JonathSpirit/GP8B/Project_GP8B.kicad_pcb

## KiCad design Project_GP8B.kicad_pcb (2023-03-18)

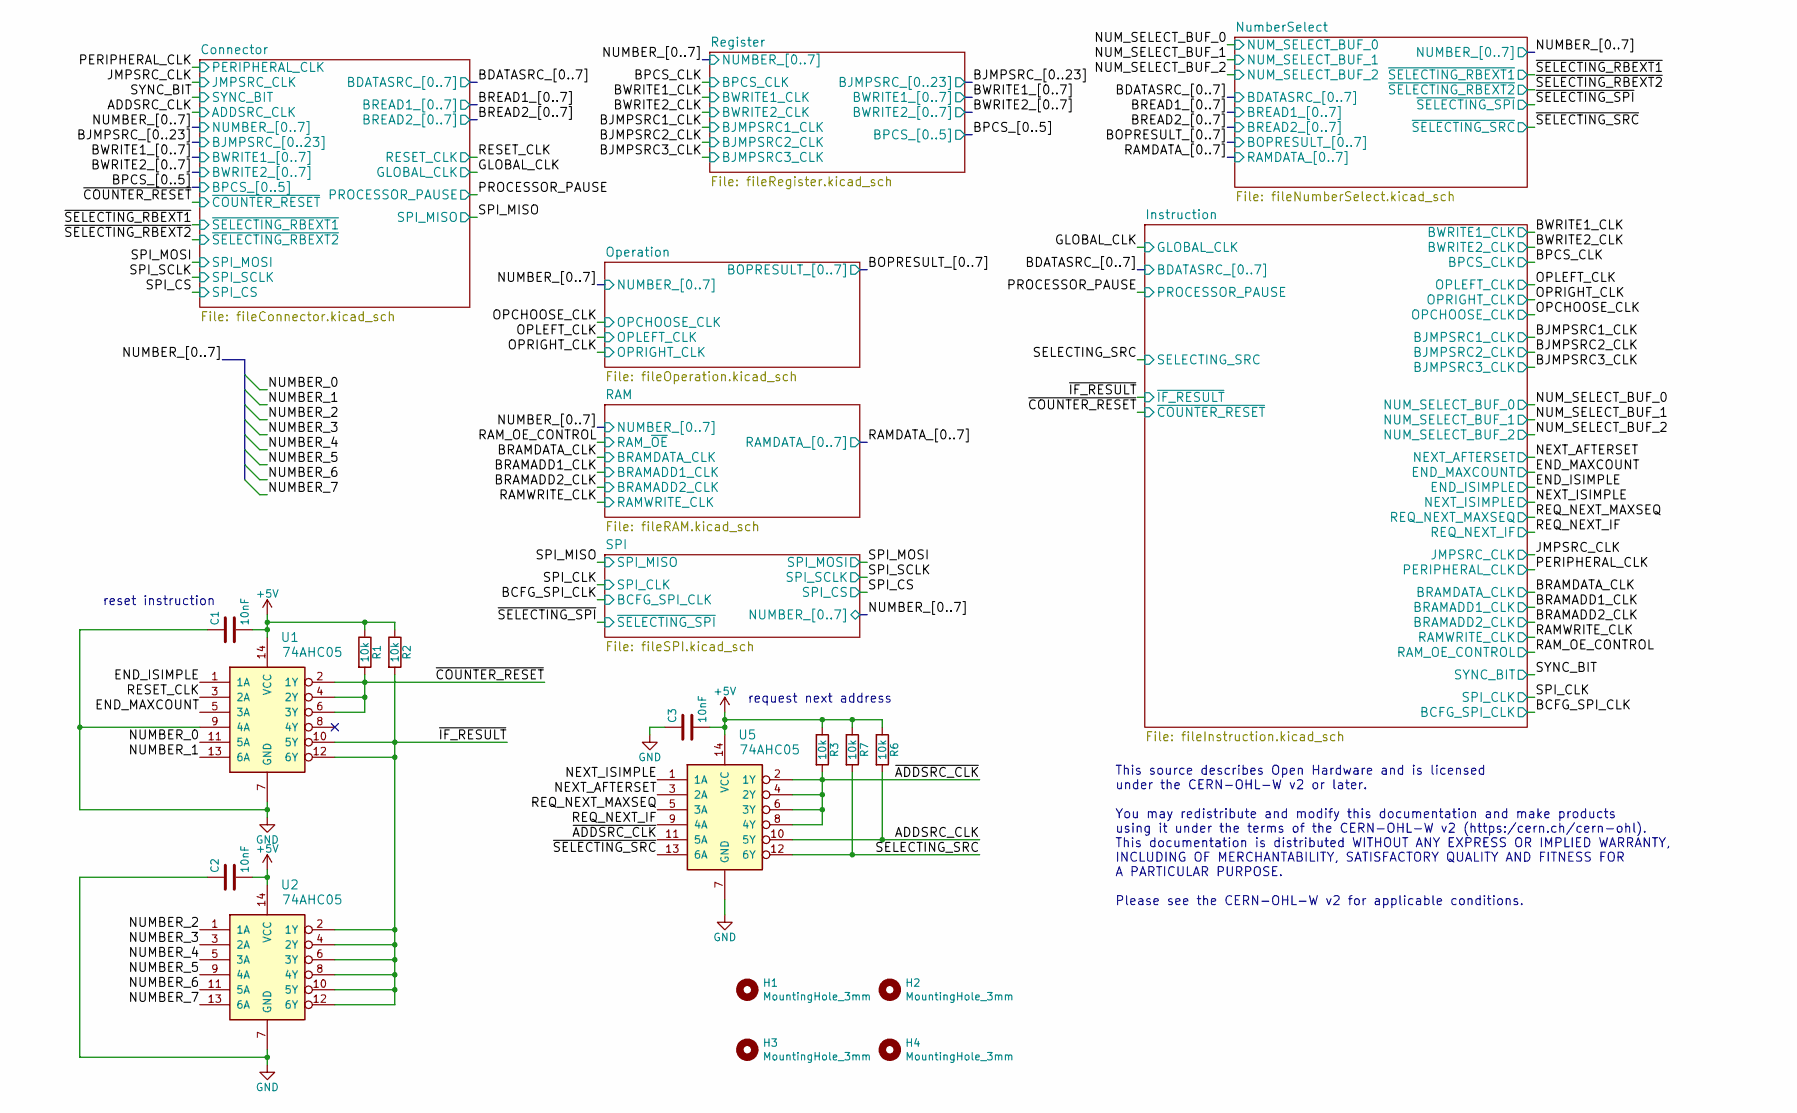
[picture p1: schematic Project_GP8B.kicad_sch, GP8B]

Parts:
C1, C2, C3: 10nF; C_0805_2012Metric
H1, H2, H3, H4: MountingHole_3mm
R1, R2, R3, R6, R7: 10k; R_0805_2012Metric
U1, U2, U5: 74AHC05; SOIC-14_3.9x8.7mm_P1.27mm

Connections:
+5V: C1.2, C2.2, C3.2, R1.1, R2.1, R3.1, R6.1, R7.1, U1.14 (VCC), U2.14 (VCC), U5.14 (VCC); also elsewhere on the board
/END_ISIMPLE: U1.1 (1A); also elsewhere on the board
/NEXT_AFTERSET: U5.3 (2A); also elsewhere on the board
/NEXT_IF: U5.9 (4A); also elsewhere on the board
/NEXT_ISIMPLE: U5.1 (1A); also elsewhere on the board
/NUMBER_0: U1.11 (5A); also elsewhere on the board
/NUMBER_1: U1.13 (6A); also elsewhere on the board
/NUMBER_2: U2.1 (1A); also elsewhere on the board
/NUMBER_3: U2.3 (2A); also elsewhere on the board
/NUMBER_4: U2.5 (3A); also elsewhere on the board
/NUMBER_5: U2.9 (4A); also elsewhere on the board
/NUMBER_6: U2.11 (5A); also elsewhere on the board
/NUMBER_7: U2.13 (6A); also elsewhere on the board
/RESET_CLK: U1.3 (2A); also elsewhere on the board
/~COUNTER_RESET: R1.2, U1.2 (1Y), U1.4 (2Y), U1.6 (3Y); also elsewhere on the board
/~SELECTING_SRC: U5.13 (6A); also elsewhere on the board

Notes on the sheet:
reset instruction
request next address
This source describes Open Hardware and is licensed under the CERN-OHL-W v2 or later. You may redistribute and modify this documentation and make products using it under the terms of the CERN-OHL-W v2 (https:/cern.ch/cern-ohl). This documentation is distributed WITHOUT ANY EXPRESS OR IMPLIED WARRAN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

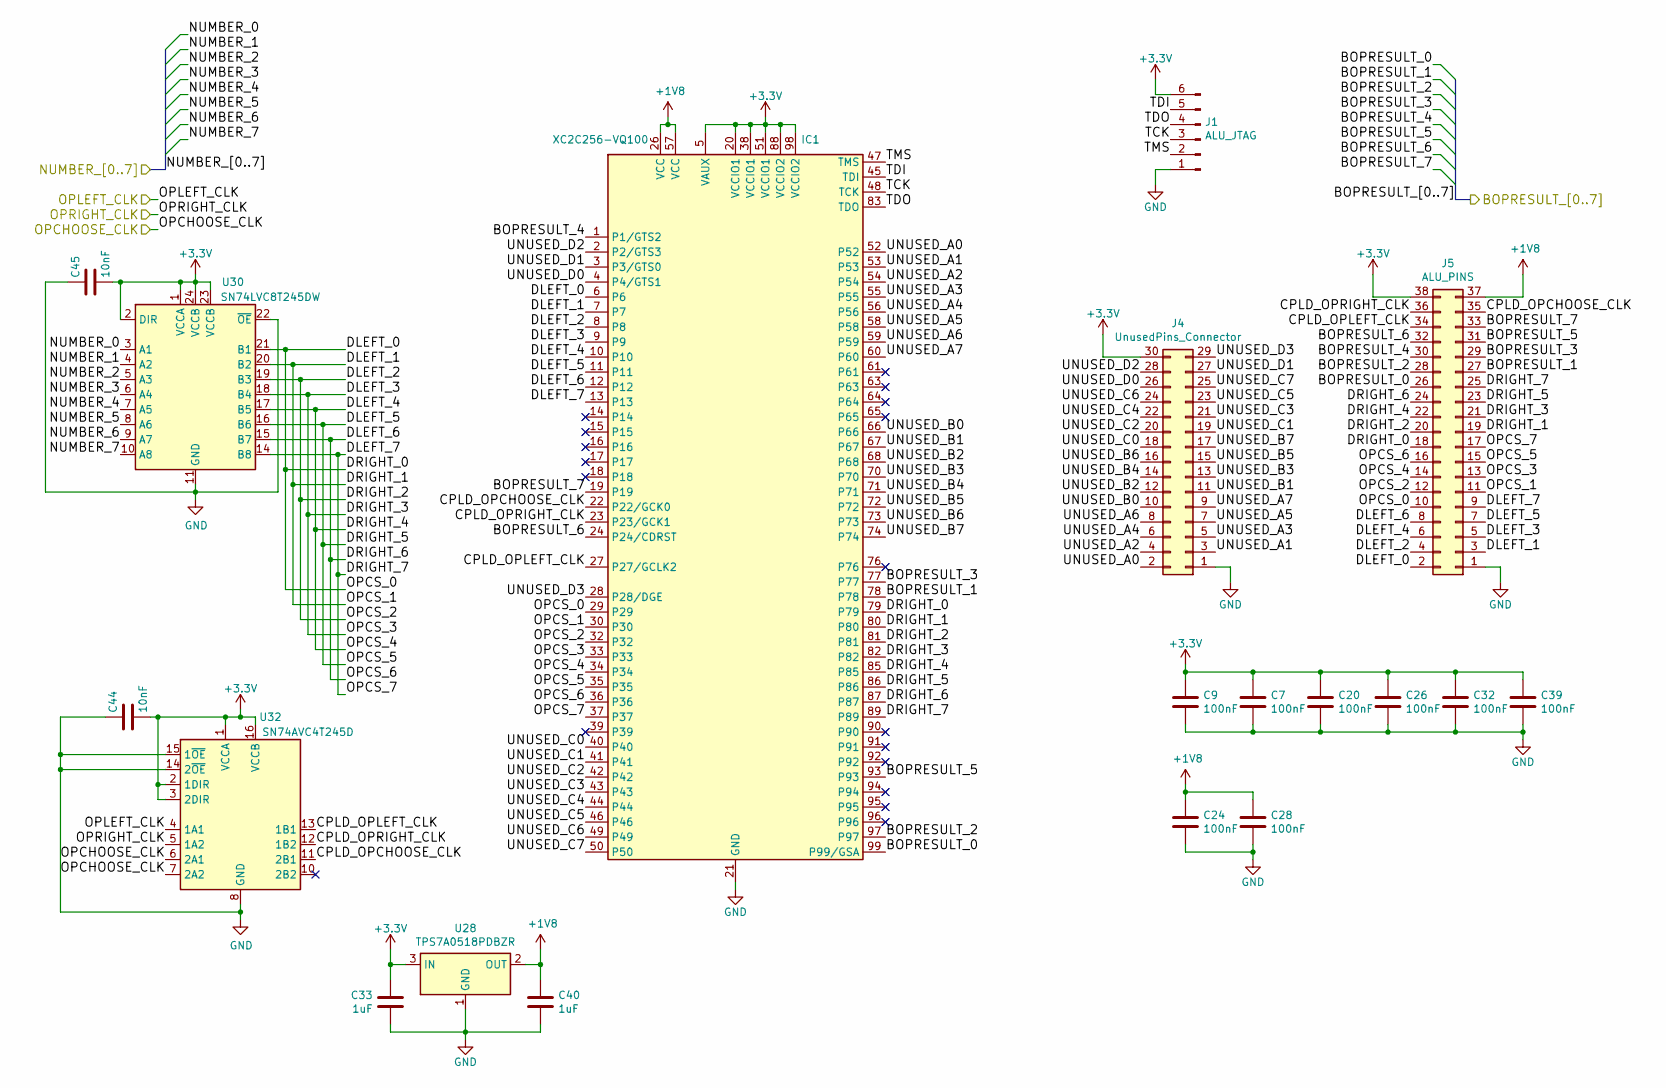
[picture p2: schematic fileOperation.kicad_sch, GP8B]

Parts:
C7, C9, C20, C24, C26, C28, C32, C39: 100nF; C_0805_2012Metric
C33, C40: 1uF; C_0805_2012Metric
C44, C45: 10nF; C_0805_2012Metric
IC1: XC2C256-VQ100; VQFP-100_14x14mm_P0.5mm
J1: ALU_JTAG; PinHeader_1x06_P2.54mm_Vertical
J4: UnusedPins_Connector; PinHeader_2x15_P1.27mm_Vertical
J5: ALU_PINS; PinHeader_2x19_P1.27mm_Vertical
U28: TPS7A0518PDBZR; SOT-23
U30: SN74LVC8T245DW; SOIC-24W_7.5x15.4mm_P1.27mm
U32: SN74AVC4T245D; SOIC-16_3.9x9.9mm_P1.27mm

Connections:
+1V8: C24.1, C28.1, C40.1, IC1.26 (VCC), IC1.57 (VCC), J5.37, U28.2 (OUT)
+3V3: C7.1, C9.1, C20.1, C26.1, C32.1, C33.1, C39.1, C44.2, C45.2, IC1.5 (VAUX), IC1.20 (VCCIO1), IC1.38 (VCCIO1), IC1.51 (VCCIO1), IC1.88 (VCCIO2), IC1.98 (VCCIO2), J1.6, J4.30, J5.38, U28.3 (IN), U30.1 (VCCA), U30.2 (DIR), U30.23 (VCCB), U30.24 (VCCB), U32.1 (VCCA), U32.2 (1DIR), U32.3 (2DIR), U32.16 (VCCB); also elsewhere on the board
/NUMBER_0: U30.3 (A1); also elsewhere on the board
/NUMBER_1: U30.4 (A2); also elsewhere on the board
/NUMBER_2: U30.5 (A3); also elsewhere on the board
/NUMBER_3: U30.6 (A4); also elsewhere on the board
/NUMBER_4: U30.7 (A5); also elsewhere on the board
/NUMBER_5: U30.8 (A6); also elsewhere on the board
/NUMBER_6: U30.9 (A7); also elsewhere on the board
/NUMBER_7: U30.10 (A8); also elsewhere on the board
/NumberSelect/BOPRESULT_0: IC1.99 (P99/GSA), J5.26; also elsewhere on the board
/NumberSelect/BOPRESULT_1: IC1.78, J5.27; also elsewhere on the board
/NumberSelect/BOPRESULT_2: IC1.97, J5.28; also elsewhere on the board
/NumberSelect/BOPRESULT_3: IC1.77, J5.29; also elsewhere on the board
/NumberSelect/BOPRESULT_4: IC1.1 (P1/GTS2), J5.30; also elsewhere on the board
/NumberSelect/BOPRESULT_5: IC1.93, J5.31; also elsewhere on the board
/NumberSelect/BOPRESULT_6: IC1.24 (P24/CDRST), J5.32; also elsewhere on the board
/NumberSelect/BOPRESULT_7: IC1.19, J5.33; also elsewhere on the board
/OPCHOOSE_CLK: U32.6 (2A1), U32.7 (2A2); also elsewhere on the board
/OPLEFT_CLK: U32.4 (1A1); also elsewhere on the board
/OPRIGHT_CLK: U32.5 (1A2); also elsewhere on the board
/Operation/CPLD_OPCHOOSE_CLK: IC1.22 (P22/GCK0), J5.35, U32.11 (2B1)
/Operation/CPLD_OPLEFT_CLK: IC1.27 (P27/GCLK2), J5.34, U32.13 (1B1)
/Operation/CPLD_OPRIGHT_CLK: IC1.23 (P23/GCK1), J5.36, U32.12 (1B2)
/Operation/DLEFT_0: IC1.6, IC1.29, IC1.79, J5.2, J5.10, J5.18, U30.21 (B1)
/Operation/DLEFT_1: IC1.7, IC1.30, IC1.80, J5.3, J5.11, J5.19, U30.20 (B2)
/Operation/DLEFT_2: IC1.8, IC1.32, IC1.81, J5.4, J5.12, J5.20, U30.19 (B3)
/Operation/DLEFT_3: IC1.9, IC1.33, IC1.82, J5.5, J5.13, J5.21, U30.18 (B4)
/Operation/DLEFT_4: IC1.10, IC1.34, IC1.85, J5.6, J5.14, J5.22, U30.17 (B5)
/Operation/DLEFT_5: IC1.11, IC1.35, IC1.86, J5.7, J5.15, J5.23, U30.16 (B6)
/Operation/DLEFT_6: IC1.12, IC1.36, IC1.87, J5.8, J5.16, J5.24, U30.15 (B7)
/Operation/DLEFT_7: IC1.13, IC1.37, IC1.89, J5.9, J5.17, J5.25, U30.14 (B8)
/Operation/TCK: IC1.48 (TCK), J1.3
/Operation/TDI: IC1.45 (TDI), J1.5
/Operation/TDO: IC1.83 (TDO), J1.4
/Operation/TMS: IC1.47 (TMS), J1.2
/Operation/UNUSED_A0: IC1.52, J4.2
/Operation/UNUSED_A1: IC1.53, J4.3
/Operation/UNUSED_A2: IC1.54, J4.4
/Operation/UNUSED_A3: IC1.55, J4.5
/Operation/UNUSED_A4: IC1.56, J4.6
/Operation/UNUSED_A5: IC1.58, J4.7
/Operation/UNUSED_A6: IC1.59, J4.8
/Operation/UNUSED_A7: IC1.60, J4.9
/Operation/UNUSED_B0: IC1.66, J4.10
/Operation/UNUSED_B1: IC1.67, J4.11
/Operation/UNUSED_B2: IC1.68, J4.12
/Operation/UNUSED_B3: IC1.70, J4.13
/Operation/UNUSED_B4: IC1.71, J4.14
/Operation/UNUSED_B5: IC1.72, J4.15
/Operation/UNUSED_B6: IC1.73, J4.16
/Operation/UNUSED_B7: IC1.74, J4.17
/Operation/UNUSED_C0: IC1.40, J4.18
/Operation/UNUSED_C1: IC1.41, J4.19
/Operation/UNUSED_C2: IC1.42, J4.20
/Operation/UNUSED_C3: IC1.43, J4.21
/Operation/UNUSED_C4: IC1.44, J4.22
/Operation/UNUSED_C5: IC1.46, J4.23
/Operation/UNUSED_C6: IC1.49, J4.24
/Operation/UNUSED_C7: IC1.50, J4.25
/Operation/UNUSED_D0: IC1.4 (P4/GTS1), J4.26
/Operation/UNUSED_D1: IC1.3 (P3/GTS0), J4.27
/Operation/UNUSED_D2: IC1.2 (P2/GTS3), J4.28
/Operation/UNUSED_D3: IC1.28 (P28/DGE), J4.29

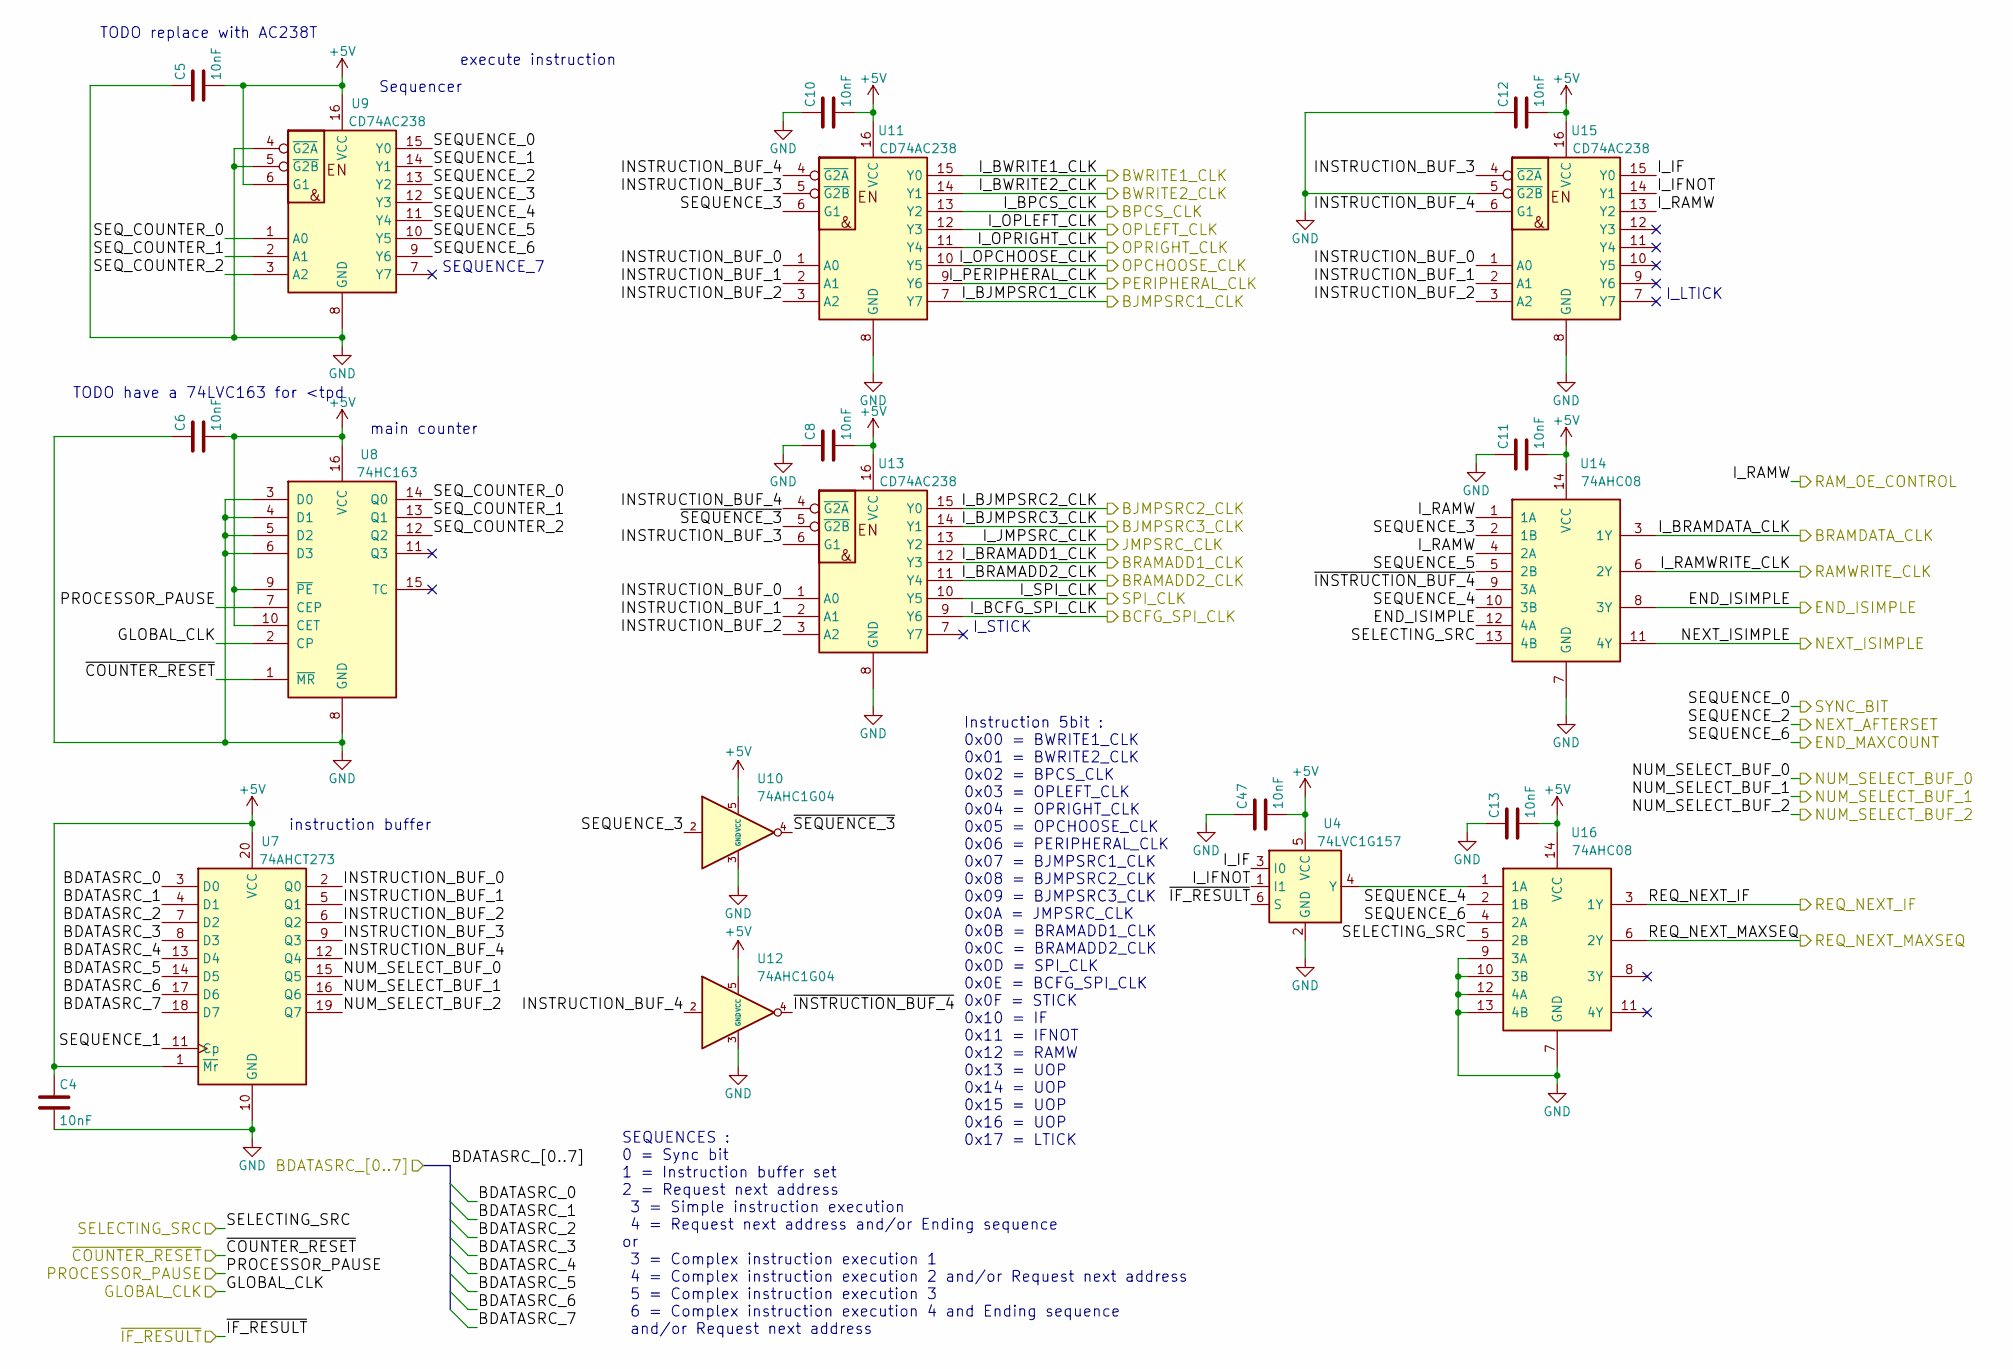
[picture p3: schematic fileInstruction.kicad_sch, GP8B]

Parts:
C4, C5, C6, C8, C10, C11, C12, C13, C47: 10nF; C_0805_2012Metric
U4: 74LVC1G157; SC-74-6_1.5x2.9mm_P0.95mm
U7: 74AHCT273; SOIC-20W_7.5x12.8mm_P1.27mm
U8: 74HC163; SOIC-16_3.9x9.9mm_P1.27mm
U9, U11, U13, U15: CD74AC238; SOIC-16_3.9x9.9mm_P1.27mm
U10, U12: 74AHC1G04; SOT-23-5
U14, U16: 74AHC08; SOIC-14_3.9x8.7mm_P1.27mm

Connections:
+5V: C4.1, C5.2, C6.2, C8.2, C10.2, C11.2, C12.2, C13.2, C47.2, U4.5 (VCC), U7.1 (~Mr), U7.20 (VCC), U8.9 (~PE), U8.10 (CET), U8.16 (VCC), U9.6 (G1), U9.16 (VCC), U10.5 (VCC), U11.16 (VCC), U12.5 (VCC), U13.16 (VCC), U14.14 (VCC), U15.16 (VCC), U16.14 (VCC); also elsewhere on the board
/BCFG_SPI_CLK: U13.9 (Y6); also elsewhere on the board
/BJMPSRC1_CLK: U11.7 (Y7); also elsewhere on the board
/BJMPSRC2_CLK: U13.15 (Y0); also elsewhere on the board
/BJMPSRC3_CLK: U13.14 (Y1); also elsewhere on the board
/BPCS_CLK: U11.13 (Y2); also elsewhere on the board
/BRAMADD1_CLK: U13.12 (Y3); also elsewhere on the board
/BRAMADD2_CLK: U13.11 (Y4); also elsewhere on the board
/BRAMDATA_CLK: U14.3 (1Y); also elsewhere on the board
/BWRITE1_CLK: U11.15 (Y0); also elsewhere on the board
/BWRITE2_CLK: U11.14 (Y1); also elsewhere on the board
/Connector/BDATASRC_0: U7.3 (D0); also elsewhere on the board
/Connector/BDATASRC_1: U7.4 (D1); also elsewhere on the board
/Connector/BDATASRC_2: U7.7 (D2); also elsewhere on the board
/Connector/BDATASRC_3: U7.8 (D3); also elsewhere on the board
/Connector/BDATASRC_4: U7.13 (D4); also elsewhere on the board
/Connector/BDATASRC_5: U7.14 (D5); also elsewhere on the board
/Connector/BDATASRC_6: U7.17 (D6); also elsewhere on the board
/Connector/BDATASRC_7: U7.18 (D7); also elsewhere on the board
/END_ISIMPLE: U14.8 (3Y), U14.12 (4A); also elsewhere on the board
/GLOBAL_CLK: U8.2 (CP); also elsewhere on the board
/Instruction/COUNTER_OUT_0: U8.14 (Q0), U9.1 (A0)
/Instruction/COUNTER_OUT_1: U8.13 (Q1), U9.2 (A1)
/Instruction/INSTRUCTION_B1: U7.2 (Q0), U11.1 (A0), U13.1 (A0), U15.1 (A0)
/Instruction/INSTRUCTION_B2: U7.5 (Q1), U11.2 (A1), U13.2 (A1), U15.2 (A1)
/Instruction/INSTRUCTION_B3: U7.6 (Q2), U11.3 (A2), U13.3 (A2), U15.3 (A2)
/Instruction/INSTRUCTION_B4: U7.9 (Q3), U11.5 (~G2B), U13.6 (G1), U15.4 (~G2A)
/Instruction/INSTRUCTION_B5: U7.12 (Q4), U11.4 (~G2A), U12.2, U13.4 (~G2A), U15.6 (G1)
/Instruction/~COUNTER_2: U10.4, U13.5 (~G2B)
/Instruction/~INSTRUCTION_B5: U12.4, U14.9 (3A)
/JMPSRC_CLK: U13.13 (Y2); also elsewhere on the board
/NEXT_AFTERSET: U7.11 (Cp), U9.14 (Y1); also elsewhere on the board
/NEXT_IF: U16.3 (1Y); also elsewhere on the board
/NEXT_ISIMPLE: U14.11 (4Y); also elsewhere on the board
/NUM_SELECT_0: U7.15 (Q5); also elsewhere on the board
/NUM_SELECT_1: U7.16 (Q6); also elsewhere on the board
/NUM_SELECT_2: U7.19 (Q7); also elsewhere on the board
/OPCHOOSE_CLK: U11.10 (Y5); also elsewhere on the board
/OPLEFT_CLK: U11.12 (Y3); also elsewhere on the board
/OPRIGHT_CLK: U11.11 (Y4); also elsewhere on the board
/PERIPHERAL_CLK: U11.9 (Y6); also elsewhere on the board
/PROCESSOR_PAUSE: U8.7 (CEP); also elsewhere on the board
/RAMWRITE_CLK: U14.6 (2Y); also elsewhere on the board
/RAM_OE_CONTROL: U14.1 (1A), U14.4 (2A), U15.13 (Y2); also elsewhere on the board
/SPI_CLK: U13.10 (Y5); also elsewhere on the board
/SYNC_BIT: U9.15 (Y0); also elsewhere on the board
/~COUNTER_RESET: U8.1 (~MR); also elsewhere on the board

Notes on the sheet:
SEQUENCE_7
instruction buffer
SEQUENCES : 0 = Sync bit 1 = Instruction buffer set 2 = Request next address 3 = Simple instruction execution 4 = Request next address and/or Ending sequence or 3 = Complex instruction execution 1 4 = Complex instruction execution 2 and/or Request next address 5 = Complex instruction execution 3 6 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
TODO replace with AC238T
Sequencer
TODO have a 74LVC163 for <tpd
main counter
execute instruction
I_LTICK
I_STICK
Instruction 5bit : 0x00 = BWRITE1_CLK 0x01 = BWRITE2_CLK 0x02 = BPCS_CLK 0x03 = OPLEFT_CLK 0x04 = OPRIGHT_CLK 0x05 = OPCHOOSE_CLK 0x06 = PERIPHERAL_CLK 0x07 = BJMPSRC1_CLK 0x08 = BJMPSRC2_CLK 0x09 = BJMPSRC3_CLK 0x0A = JMPSRC_CLK 0x0B = BRAMADD1_CLK 0x0C = BRAMADD2_CLK 0x0D = SPI_CLK 0x0E = BCFG_SP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

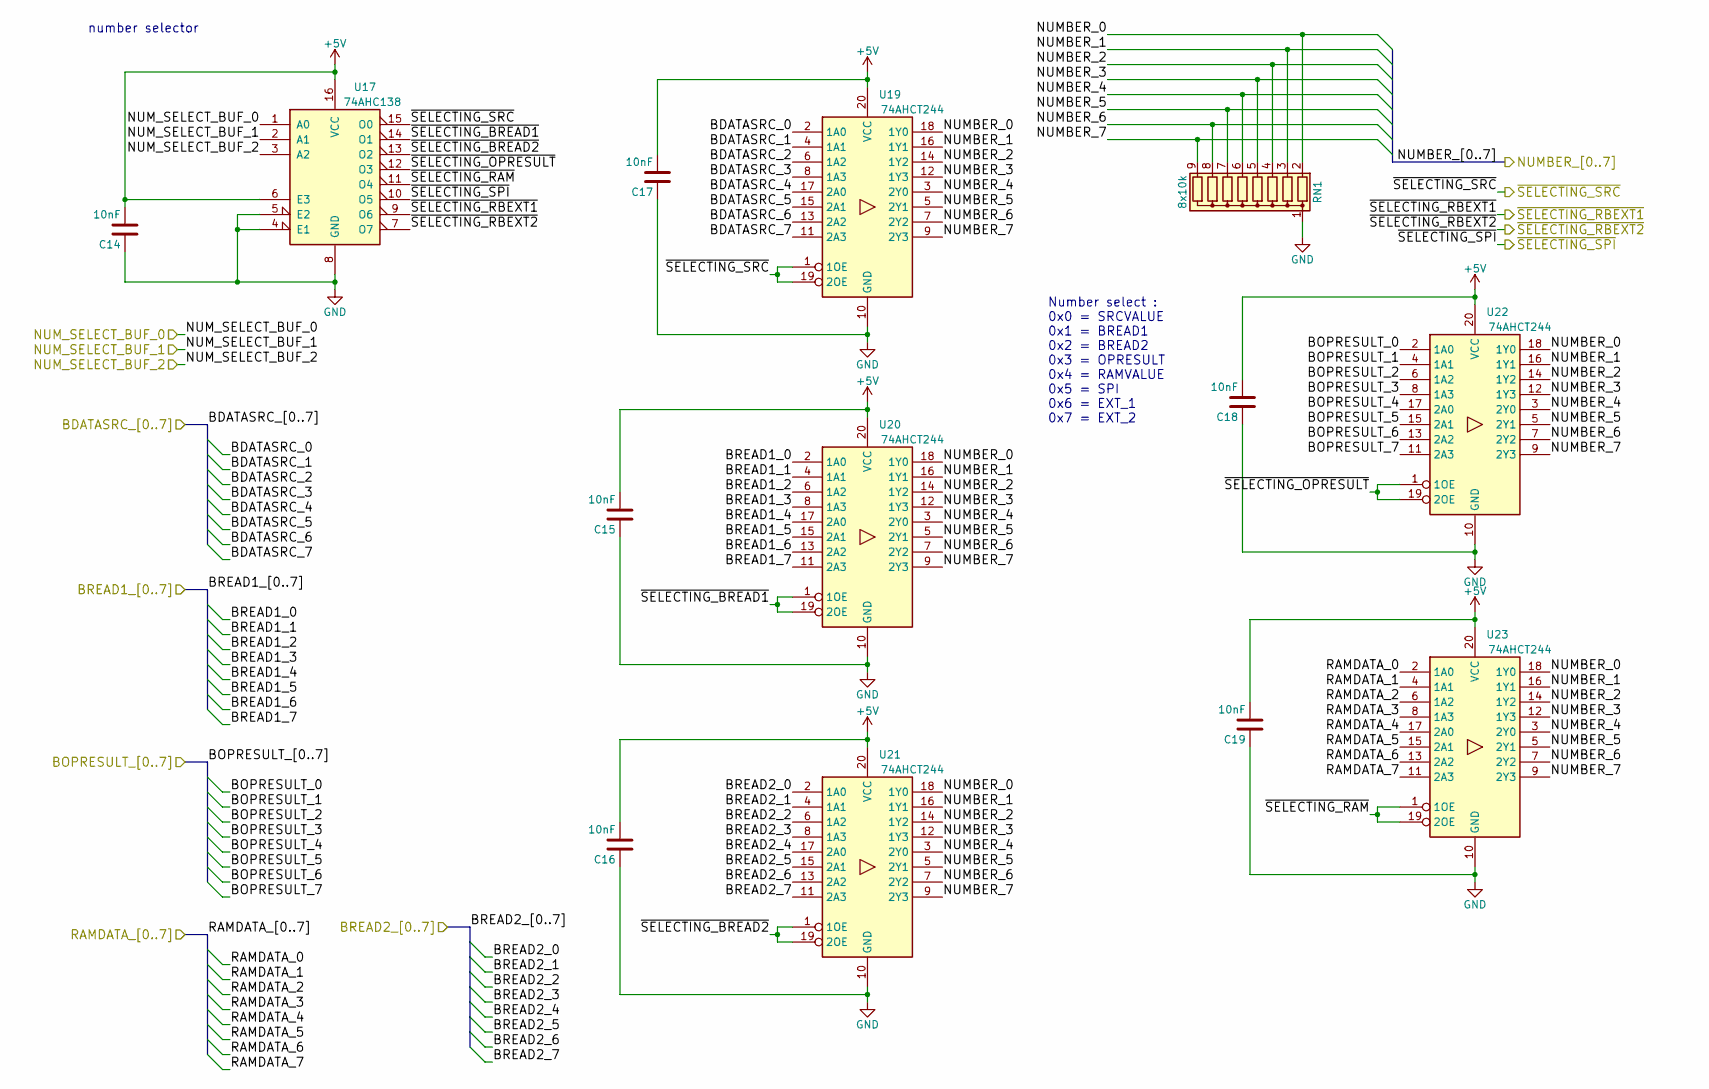
[picture p4: schematic fileNumberSelect.kicad_sch, GP8B]

Parts:
C14, C15, C16, C17, C18, C19: 10nF; C_0805_2012Metric
RN1: 8x10k; R_Array_SIP9
U17: 74AHC138; SOIC-16W_5.3x10.2mm_P1.27mm
U19, U20, U21, U22, U23: 74AHCT244; SOIC-20W_7.5x12.8mm_P1.27mm

Connections:
+5V: C14.2, C15.2, C16.2, C17.2, C18.2, C19.2, U17.6 (E3), U17.16 (VCC), U19.20 (VCC), U20.20 (VCC), U21.20 (VCC), U22.20 (VCC), U23.20 (VCC); also elsewhere on the board
/Connector/BDATASRC_0: U19.2 (1A0); also elsewhere on the board
/Connector/BDATASRC_1: U19.4 (1A1); also elsewhere on the board
/Connector/BDATASRC_2: U19.6 (1A2); also elsewhere on the board
/Connector/BDATASRC_3: U19.8 (1A3); also elsewhere on the board
/Connector/BDATASRC_4: U19.17 (2A0); also elsewhere on the board
/Connector/BDATASRC_5: U19.15 (2A1); also elsewhere on the board
/Connector/BDATASRC_6: U19.13 (2A2); also elsewhere on the board
/Connector/BDATASRC_7: U19.11 (2A3); also elsewhere on the board
/Connector/BREAD1_0: U20.2 (1A0); also elsewhere on the board
/Connector/BREAD1_1: U20.4 (1A1); also elsewhere on the board
/Connector/BREAD1_2: U20.6 (1A2); also elsewhere on the board
/Connector/BREAD1_3: U20.8 (1A3); also elsewhere on the board
/Connector/BREAD1_4: U20.17 (2A0); also elsewhere on the board
/Connector/BREAD1_5: U20.15 (2A1); also elsewhere on the board
/Connector/BREAD1_6: U20.13 (2A2); also elsewhere on the board
/Connector/BREAD1_7: U20.11 (2A3); also elsewhere on the board
/Connector/BREAD2_0: U21.2 (1A0); also elsewhere on the board
/Connector/BREAD2_1: U21.4 (1A1); also elsewhere on the board
/Connector/BREAD2_2: U21.6 (1A2); also elsewhere on the board
/Connector/BREAD2_3: U21.8 (1A3); also elsewhere on the board
/Connector/BREAD2_4: U21.17 (2A0); also elsewhere on the board
/Connector/BREAD2_5: U21.15 (2A1); also elsewhere on the board
/Connector/BREAD2_6: U21.13 (2A2); also elsewhere on the board
/Connector/BREAD2_7: U21.11 (2A3); also elsewhere on the board
/NUMBER_0: RN1.2 (R1), U19.18 (1Y0), U20.18 (1Y0), U21.18 (1Y0), U22.18 (1Y0), U23.18 (1Y0); also elsewhere on the board
/NUMBER_1: RN1.3 (R2), U19.16 (1Y1), U20.16 (1Y1), U21.16 (1Y1), U22.16 (1Y1), U23.16 (1Y1); also elsewhere on the board
/NUMBER_2: RN1.4 (R3), U19.14 (1Y2), U20.14 (1Y2), U21.14 (1Y2), U22.14 (1Y2), U23.14 (1Y2); also elsewhere on the board
/NUMBER_3: RN1.5 (R4), U19.12 (1Y3), U20.12 (1Y3), U21.12 (1Y3), U22.12 (1Y3), U23.12 (1Y3); also elsewhere on the board
/NUMBER_4: RN1.6 (R5), U19.3 (2Y0), U20.3 (2Y0), U21.3 (2Y0), U22.3 (2Y0), U23.3 (2Y0); also elsewhere on the board
/NUMBER_5: RN1.7 (R6), U19.5 (2Y1), U20.5 (2Y1), U21.5 (2Y1), U22.5 (2Y1), U23.5 (2Y1); also elsewhere on the board
/NUMBER_6: RN1.8 (R7), U19.7 (2Y2), U20.7 (2Y2), U21.7 (2Y2), U22.7 (2Y2), U23.7 (2Y2); also elsewhere on the board
/NUMBER_7: RN1.9 (R8), U19.9 (2Y3), U20.9 (2Y3), U21.9 (2Y3), U22.9 (2Y3), U23.9 (2Y3); also elsewhere on the board
/NUM_SELECT_0: U17.1 (A0); also elsewhere on the board
/NUM_SELECT_1: U17.2 (A1); also elsewhere on the board
/NUM_SELECT_2: U17.3 (A2); also elsewhere on the board
/NumberSelect/BOPRESULT_0: U22.2 (1A0); also elsewhere on the board
/NumberSelect/BOPRESULT_1: U22.4 (1A1); also elsewhere on the board
/NumberSelect/BOPRESULT_2: U22.6 (1A2); also elsewhere on the board
/NumberSelect/BOPRESULT_3: U22.8 (1A3); also elsewhere on the board
/NumberSelect/BOPRESULT_4: U22.17 (2A0); also elsewhere on the board
/NumberSelect/BOPRESULT_5: U22.15 (2A1); also elsewhere on the board
/NumberSelect/BOPRESULT_6: U22.13 (2A2); also elsewhere on the board
/NumberSelect/BOPRESULT_7: U22.11 (2A3); also elsewhere on the board
/NumberSelect/RAMDATA_0: U23.2 (1A0); also elsewhere on the board
/NumberSelect/RAMDATA_1: U23.4 (1A1); also elsewhere on the board
/NumberSelect/RAMDATA_2: U23.6 (1A2); also elsewhere on the board
/NumberSelect/RAMDATA_3: U23.8 (1A3); also elsewhere on the board
/NumberSelect/RAMDATA_4: U23.17 (2A0); also elsewhere on the board
/NumberSelect/RAMDATA_5: U23.15 (2A1); also elsewhere on the board
/NumberSelect/RAMDATA_6: U23.13 (2A2); also elsewhere on the board
/NumberSelect/RAMDATA_7: U23.11 (2A3); also elsewhere on the board
/NumberSelect/~SELECTING_BREAD1: U17.14 (O1), U20.1 (1OE), U20.19 (2OE)
/NumberSelect/~SELECTING_BREAD2: U17.13 (O2), U21.1 (1OE), U21.19 (2OE)
/NumberSelect/~SELECTING_OPRESULT: U17.12 (O3), U22.1 (1OE), U22.19 (2OE)
/NumberSelect/~SELECTING_RAM: U17.11 (O4), U23.1 (1OE), U23.19 (2OE)
/~SELECTING_RBEXT1: U17.9 (O6); also elsewhere on the board
/~SELECTING_RBEXT2: U17.7 (O7); also elsewhere on the board
/~SELECTING_SPI: U17.10 (O5); also elsewhere on the board
/~SELECTING_SRC: U17.15 (O0), U19.1 (1OE), U19.19 (2OE); also elsewhere on the board

Notes on the sheet:
Number select : 0x0 = SRCVALUE 0x1 = BREAD1 0x2 = BREAD2 0x3 = OPRESULT 0x4 = RAMVALUE 0x5 = SPI 0x6 = EXT_1 0x7 = EXT_2
number selector

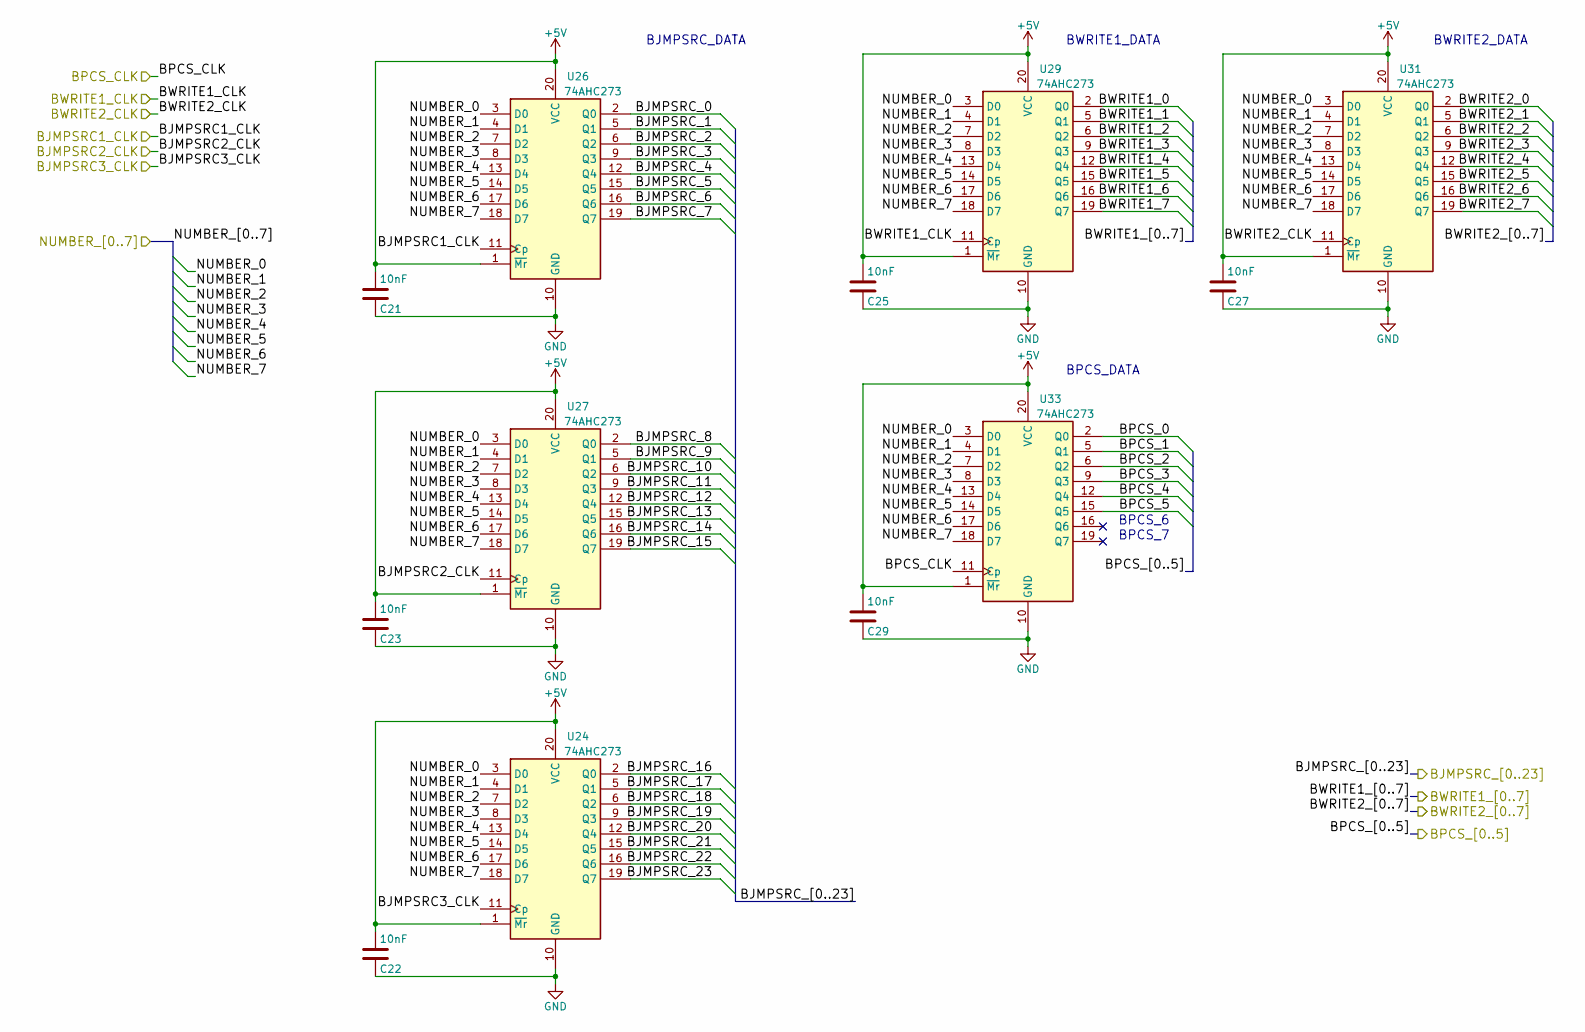
[picture p5: schematic fileRegister.kicad_sch, GP8B]

Parts:
C21, C22, C23, C25, C27, C29: 10nF; C_0805_2012Metric
U24, U26, U27, U29, U31, U33: 74AHC273; SOIC-20W_7.5x12.8mm_P1.27mm

Connections:
+5V: C21.2, C22.2, C23.2, C25.2, C27.2, C29.2, U24.1 (~Mr), U24.20 (VCC), U26.1 (~Mr), U26.20 (VCC), U27.1 (~Mr), U27.20 (VCC), U29.1 (~Mr), U29.20 (VCC), U31.1 (~Mr), U31.20 (VCC), U33.1 (~Mr), U33.20 (VCC); also elsewhere on the board
/BJMPSRC1_CLK: U26.11 (Cp); also elsewhere on the board
/BJMPSRC2_CLK: U27.11 (Cp); also elsewhere on the board
/BJMPSRC3_CLK: U24.11 (Cp); also elsewhere on the board
/BPCS_CLK: U33.11 (Cp); also elsewhere on the board
/BWRITE1_CLK: U29.11 (Cp); also elsewhere on the board
/BWRITE2_CLK: U31.11 (Cp); also elsewhere on the board
/Connector/BJMPSRC_0: U26.2 (Q0); also elsewhere on the board
/Connector/BJMPSRC_1: U26.5 (Q1); also elsewhere on the board
/Connector/BJMPSRC_2: U26.6 (Q2); also elsewhere on the board
/Connector/BJMPSRC_3: U26.9 (Q3); also elsewhere on the board
/Connector/BJMPSRC_4: U26.12 (Q4); also elsewhere on the board
/Connector/BJMPSRC_5: U26.15 (Q5); also elsewhere on the board
/Connector/BJMPSRC_6: U26.16 (Q6); also elsewhere on the board
/Connector/BJMPSRC_7: U26.19 (Q7); also elsewhere on the board
/Connector/BJMPSRC_8: U27.2 (Q0); also elsewhere on the board
/Connector/BJMPSRC_9: U27.5 (Q1); also elsewhere on the board
/Connector/BJMPSRC_10: U27.6 (Q2); also elsewhere on the board
/Connector/BJMPSRC_11: U27.9 (Q3); also elsewhere on the board
/Connector/BJMPSRC_12: U27.12 (Q4); also elsewhere on the board
/Connector/BJMPSRC_13: U27.15 (Q5); also elsewhere on the board
/Connector/BJMPSRC_14: U27.16 (Q6); also elsewhere on the board
/Connector/BJMPSRC_15: U27.19 (Q7); also elsewhere on the board
/Connector/BJMPSRC_16: U24.2 (Q0); also elsewhere on the board
/Connector/BJMPSRC_17: U24.5 (Q1); also elsewhere on the board
/Connector/BJMPSRC_18: U24.6 (Q2); also elsewhere on the board
/Connector/BJMPSRC_19: U24.9 (Q3); also elsewhere on the board
/Connector/BJMPSRC_20: U24.12 (Q4); also elsewhere on the board
/Connector/BJMPSRC_21: U24.15 (Q5); also elsewhere on the board
/Connector/BJMPSRC_22: U24.16 (Q6); also elsewhere on the board
/Connector/BJMPSRC_23: U24.19 (Q7); also elsewhere on the board
/Connector/BPCS_0: U33.2 (Q0); also elsewhere on the board
/Connector/BPCS_1: U33.5 (Q1); also elsewhere on the board
/Connector/BPCS_2: U33.6 (Q2); also elsewhere on the board
/Connector/BPCS_3: U33.9 (Q3); also elsewhere on the board
/Connector/BPCS_4: U33.12 (Q4); also elsewhere on the board
/Connector/BPCS_5: U33.15 (Q5); also elsewhere on the board
/Connector/BWRITE1_0: U29.2 (Q0); also elsewhere on the board
/Connector/BWRITE1_1: U29.5 (Q1); also elsewhere on the board
/Connector/BWRITE1_2: U29.6 (Q2); also elsewhere on the board
/Connector/BWRITE1_3: U29.9 (Q3); also elsewhere on the board
/Connector/BWRITE1_4: U29.12 (Q4); also elsewhere on the board
/Connector/BWRITE1_5: U29.15 (Q5); also elsewhere on the board
/Connector/BWRITE1_6: U29.16 (Q6); also elsewhere on the board
/Connector/BWRITE1_7: U29.19 (Q7); also elsewhere on the board
/Connector/BWRITE2_0: U31.2 (Q0); also elsewhere on the board
/Connector/BWRITE2_1: U31.5 (Q1); also elsewhere on the board
/Connector/BWRITE2_2: U31.6 (Q2); also elsewhere on the board
/Connector/BWRITE2_3: U31.9 (Q3); also elsewhere on the board
/Connector/BWRITE2_4: U31.12 (Q4); also elsewhere on the board
/Connector/BWRITE2_5: U31.15 (Q5); also elsewhere on the board
/Connector/BWRITE2_6: U31.16 (Q6); also elsewhere on the board
/Connector/BWRITE2_7: U31.19 (Q7); also elsewhere on the board
/NUMBER_0: U24.3 (D0), U26.3 (D0), U27.3 (D0), U29.3 (D0), U31.3 (D0), U33.3 (D0); also elsewhere on the board
/NUMBER_1: U24.4 (D1), U26.4 (D1), U27.4 (D1), U29.4 (D1), U31.4 (D1), U33.4 (D1); also elsewhere on the board
/NUMBER_2: U24.7 (D2), U26.7 (D2), U27.7 (D2), U29.7 (D2), U31.7 (D2), U33.7 (D2); also elsewhere on the board
/NUMBER_3: U24.8 (D3), U26.8 (D3), U27.8 (D3), U29.8 (D3), U31.8 (D3), U33.8 (D3); also elsewhere on the board
/NUMBER_4: U24.13 (D4), U26.13 (D4), U27.13 (D4), U29.13 (D4), U31.13 (D4), U33.13 (D4); also elsewhere on the board
/NUMBER_5: U24.14 (D5), U26.14 (D5), U27.14 (D5), U29.14 (D5), U31.14 (D5), U33.14 (D5); also elsewhere on the board
/NUMBER_6: U24.17 (D6), U26.17 (D6), U27.17 (D6), U29.17 (D6), U31.17 (D6), U33.17 (D6); also elsewhere on the board
/NUMBER_7: U24.18 (D7), U26.18 (D7), U27.18 (D7), U29.18 (D7), U31.18 (D7), U33.18 (D7); also elsewhere on the board

Notes on the sheet:
BPCS_DATA
BWRITE2_DATA
BWRITE1_DATA
BJMPSRC_DATA
BPCS_6
BPCS_7
