JonathSpirit/GP8B/Project_GP8B.kicad_pcb

## KiCad design Project_GP8B.kicad_pcb (continued)

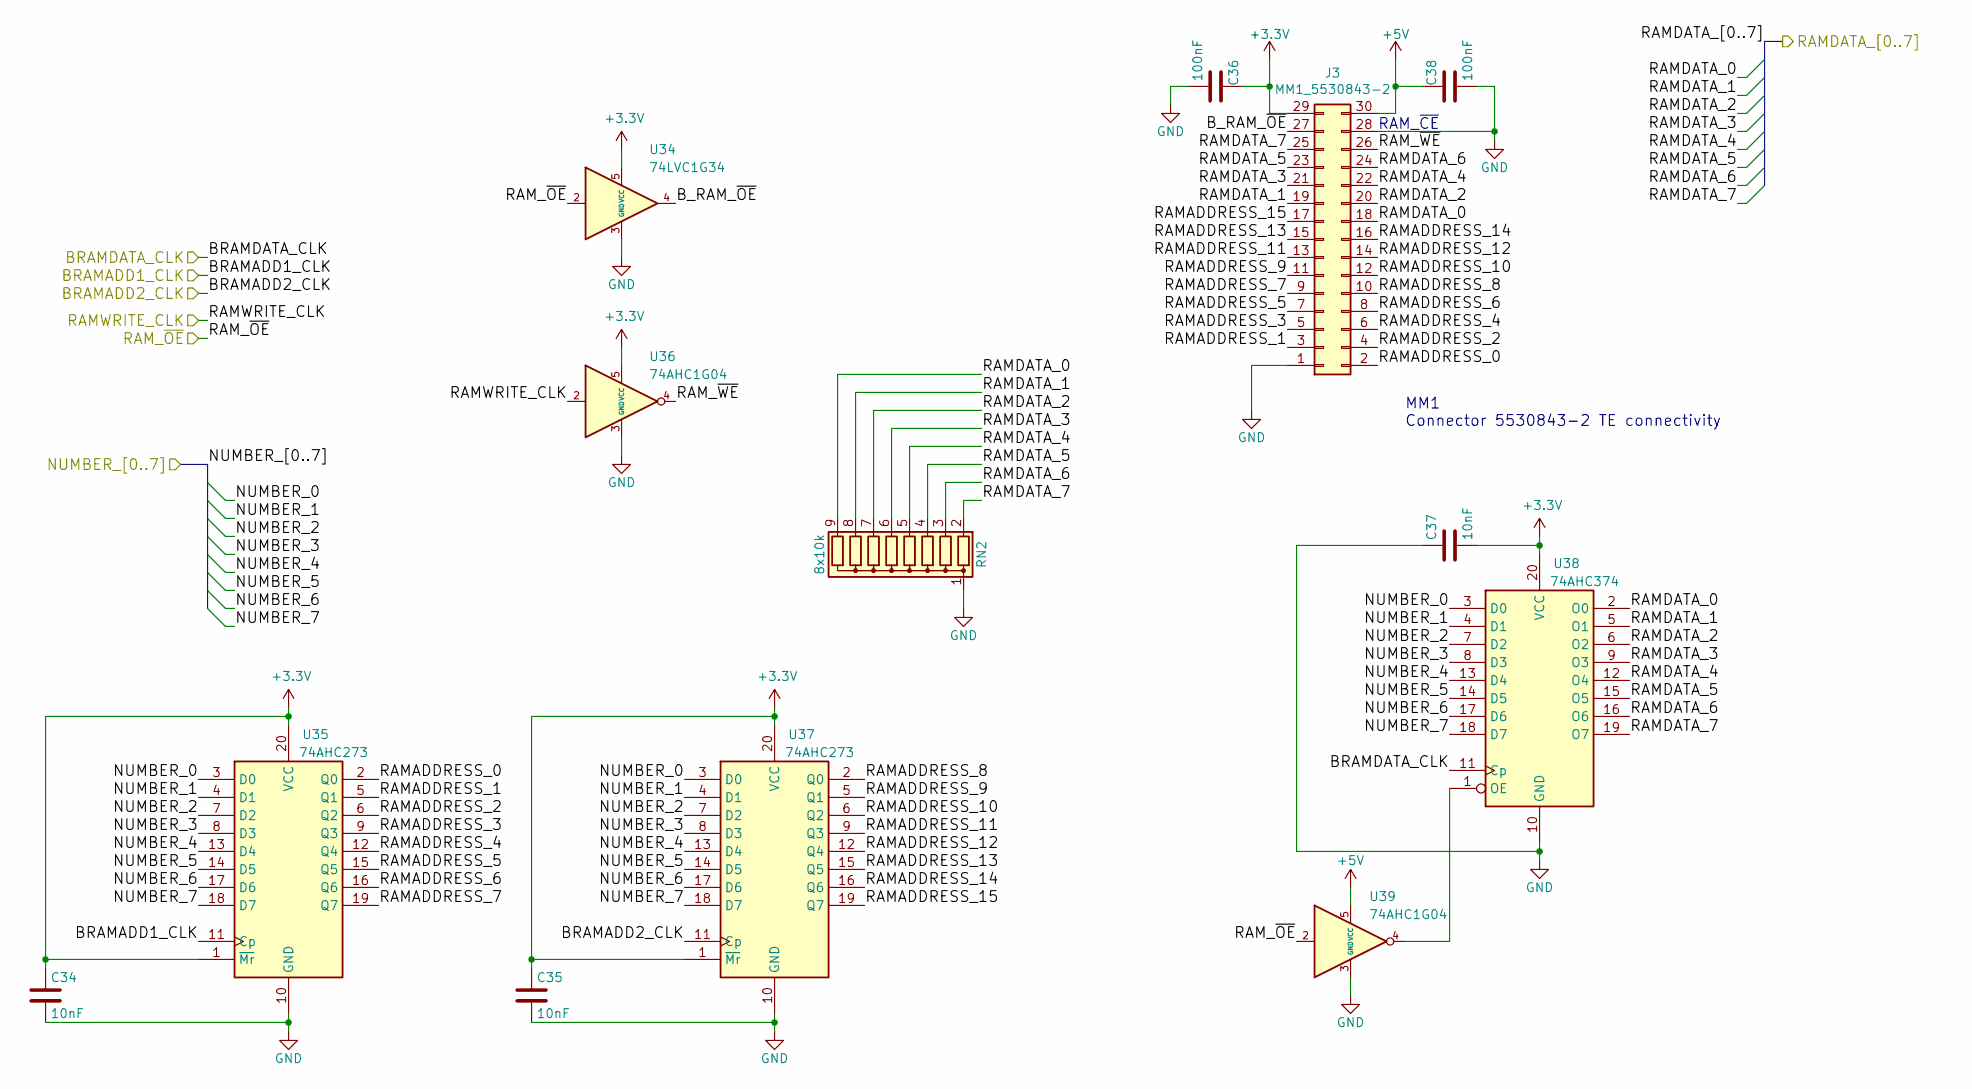
[picture p6: schematic fileRAM.kicad_sch, GP8B]

Parts:
C34, C35, C37: 10nF; C_0805_2012Metric
C36, C38: 100nF; C_0805_2012Metric
J3: MM1_5530843-2; TE_5530843-2
RN2: 8x10k; R_Array_SIP9
U34: 74LVC1G34; SOT-23-5
U35, U37: 74AHC273; SOIC-20W_7.5x12.8mm_P1.27mm
U36, U39: 74AHC1G04; SOT-23-5
U38: 74AHC374; SOIC-20W_7.5x12.8mm_P1.27mm

Connections:
+3V3: C34.1, C35.1, C36.1, C37.2, J3.29, U34.5 (VCC), U35.1 (~Mr), U35.20 (VCC), U36.5 (VCC), U37.1 (~Mr), U37.20 (VCC), U38.20 (VCC); also elsewhere on the board
+5V: C38.1, J3.30, U39.5 (VCC); also elsewhere on the board
/BRAMADD1_CLK: U35.11 (Cp); also elsewhere on the board
/BRAMADD2_CLK: U37.11 (Cp); also elsewhere on the board
/BRAMDATA_CLK: U38.11 (Cp); also elsewhere on the board
/NUMBER_0: U35.3 (D0), U37.3 (D0), U38.3 (D0); also elsewhere on the board
/NUMBER_1: U35.4 (D1), U37.4 (D1), U38.4 (D1); also elsewhere on the board
/NUMBER_2: U35.7 (D2), U37.7 (D2), U38.7 (D2); also elsewhere on the board
/NUMBER_3: U35.8 (D3), U37.8 (D3), U38.8 (D3); also elsewhere on the board
/NUMBER_4: U35.13 (D4), U37.13 (D4), U38.13 (D4); also elsewhere on the board
/NUMBER_5: U35.14 (D5), U37.14 (D5), U38.14 (D5); also elsewhere on the board
/NUMBER_6: U35.17 (D6), U37.17 (D6), U38.17 (D6); also elsewhere on the board
/NUMBER_7: U35.18 (D7), U37.18 (D7), U38.18 (D7); also elsewhere on the board
/NumberSelect/RAMDATA_0: J3.18, RN2.9 (R8), U38.2 (O0); also elsewhere on the board
/NumberSelect/RAMDATA_1: J3.19, RN2.8 (R7), U38.5 (O1); also elsewhere on the board
/NumberSelect/RAMDATA_2: J3.20, RN2.7 (R6), U38.6 (O2); also elsewhere on the board
/NumberSelect/RAMDATA_3: J3.21, RN2.6 (R5), U38.9 (O3); also elsewhere on the board
/NumberSelect/RAMDATA_4: J3.22, RN2.5 (R4), U38.12 (O4); also elsewhere on the board
/NumberSelect/RAMDATA_5: J3.23, RN2.4 (R3), U38.15 (O5); also elsewhere on the board
/NumberSelect/RAMDATA_6: J3.24, RN2.3 (R2), U38.16 (O6); also elsewhere on the board
/NumberSelect/RAMDATA_7: J3.25, RN2.2 (R1), U38.19 (O7); also elsewhere on the board
/RAM/B_RAM_~OE: J3.27, U34.4
/RAM/RAMADDRESS_0: J3.2, U35.2 (Q0)
/RAM/RAMADDRESS_1: J3.3, U35.5 (Q1)
/RAM/RAMADDRESS_2: J3.4, U35.6 (Q2)
/RAM/RAMADDRESS_3: J3.5, U35.9 (Q3)
/RAM/RAMADDRESS_4: J3.6, U35.12 (Q4)
/RAM/RAMADDRESS_5: J3.7, U35.15 (Q5)
/RAM/RAMADDRESS_6: J3.8, U35.16 (Q6)
/RAM/RAMADDRESS_7: J3.9, U35.19 (Q7)
/RAM/RAMADDRESS_8: J3.10, U37.2 (Q0)
/RAM/RAMADDRESS_9: J3.11, U37.5 (Q1)
/RAM/RAMADDRESS_10: J3.12, U37.6 (Q2)
/RAM/RAMADDRESS_11: J3.13, U37.9 (Q3)
/RAM/RAMADDRESS_12: J3.14, U37.12 (Q4)
/RAM/RAMADDRESS_13: J3.15, U37.15 (Q5)
/RAM/RAMADDRESS_14: J3.16, U37.16 (Q6)
/RAM/RAMADDRESS_15: J3.17, U37.19 (Q7)
/RAM/RAM_~WE: J3.26, U36.4
/RAMWRITE_CLK: U36.2; also elsewhere on the board
/RAM_OE_CONTROL: U34.2, U39.2; also elsewhere on the board
unnamed: U38.1 (OE), U39.4

Notes on the sheet:
MM1 Connector 5530843-2 TE connectivity
RAM_~{CE}

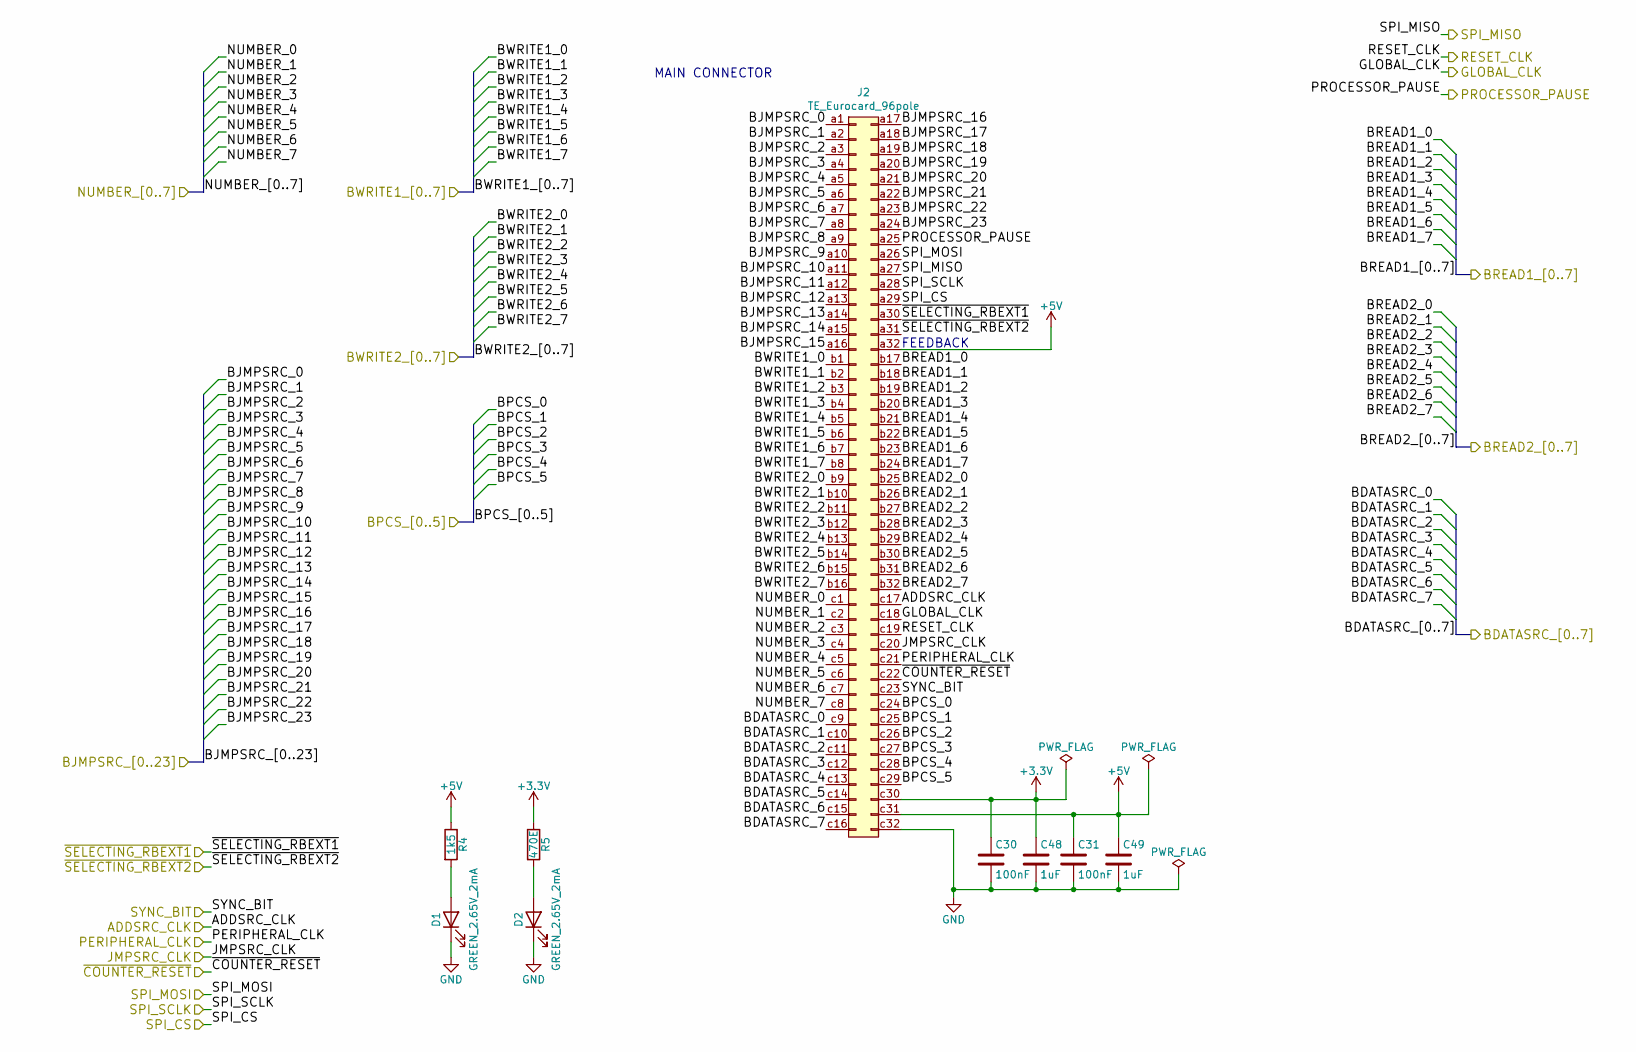
[picture p7: schematic fileConnector.kicad_sch, GP8B]

Parts:
C30, C31: 100nF; C_0805_2012Metric
C48, C49: 1uF; C_0805_2012Metric
D1, D2: GREEN_2.65V_2mA; LED_1206_3216Metric
J2: TE_Eurocard_96pole; Eurocard_5536475-1
R4: 1k5; R_0805_2012Metric
R5: 470E; R_0805_2012Metric

Connections:
+3V3: C30.1, C48.1, J2.c30, R5.1; also elsewhere on the board
+5V: C31.1, C49.1, J2.a32, J2.c31, R4.1; also elsewhere on the board
/ADDSRC_CLK: J2.c17; also elsewhere on the board
/Connector/BDATASRC_0: J2.c9; also elsewhere on the board
/Connector/BDATASRC_1: J2.c10; also elsewhere on the board
/Connector/BDATASRC_2: J2.c11; also elsewhere on the board
/Connector/BDATASRC_3: J2.c12; also elsewhere on the board
/Connector/BDATASRC_4: J2.c13; also elsewhere on the board
/Connector/BDATASRC_5: J2.c14; also elsewhere on the board
/Connector/BDATASRC_6: J2.c15; also elsewhere on the board
/Connector/BDATASRC_7: J2.c16; also elsewhere on the board
/Connector/BJMPSRC_0: J2.a1; also elsewhere on the board
/Connector/BJMPSRC_1: J2.a2; also elsewhere on the board
/Connector/BJMPSRC_2: J2.a3; also elsewhere on the board
/Connector/BJMPSRC_3: J2.a4; also elsewhere on the board
/Connector/BJMPSRC_4: J2.a5; also elsewhere on the board
/Connector/BJMPSRC_5: J2.a6; also elsewhere on the board
/Connector/BJMPSRC_6: J2.a7; also elsewhere on the board
/Connector/BJMPSRC_7: J2.a8; also elsewhere on the board
/Connector/BJMPSRC_8: J2.a9; also elsewhere on the board
/Connector/BJMPSRC_9: J2.a10; also elsewhere on the board
/Connector/BJMPSRC_10: J2.a11; also elsewhere on the board
/Connector/BJMPSRC_11: J2.a12; also elsewhere on the board
/Connector/BJMPSRC_12: J2.a13; also elsewhere on the board
/Connector/BJMPSRC_13: J2.a14; also elsewhere on the board
/Connector/BJMPSRC_14: J2.a15; also elsewhere on the board
/Connector/BJMPSRC_15: J2.a16; also elsewhere on the board
/Connector/BJMPSRC_16: J2.a17; also elsewhere on the board
/Connector/BJMPSRC_17: J2.a18; also elsewhere on the board
/Connector/BJMPSRC_18: J2.a19; also elsewhere on the board
/Connector/BJMPSRC_19: J2.a20; also elsewhere on the board
/Connector/BJMPSRC_20: J2.a21; also elsewhere on the board
/Connector/BJMPSRC_21: J2.a22; also elsewhere on the board
/Connector/BJMPSRC_22: J2.a23; also elsewhere on the board
/Connector/BJMPSRC_23: J2.a24; also elsewhere on the board
/Connector/BPCS_0: J2.c24; also elsewhere on the board
/Connector/BPCS_1: J2.c25; also elsewhere on the board
/Connector/BPCS_2: J2.c26; also elsewhere on the board
/Connector/BPCS_3: J2.c27; also elsewhere on the board
/Connector/BPCS_4: J2.c28; also elsewhere on the board
/Connector/BPCS_5: J2.c29; also elsewhere on the board
/Connector/BREAD1_0: J2.b17; also elsewhere on the board
/Connector/BREAD1_1: J2.b18; also elsewhere on the board
/Connector/BREAD1_2: J2.b19; also elsewhere on the board
/Connector/BREAD1_3: J2.b20; also elsewhere on the board
/Connector/BREAD1_4: J2.b21; also elsewhere on the board
/Connector/BREAD1_5: J2.b22; also elsewhere on the board
/Connector/BREAD1_6: J2.b23; also elsewhere on the board
/Connector/BREAD1_7: J2.b24; also elsewhere on the board
/Connector/BREAD2_0: J2.b25; also elsewhere on the board
/Connector/BREAD2_1: J2.b26; also elsewhere on the board
/Connector/BREAD2_2: J2.b27; also elsewhere on the board
/Connector/BREAD2_3: J2.b28; also elsewhere on the board
/Connector/BREAD2_4: J2.b29; also elsewhere on the board
/Connector/BREAD2_5: J2.b30; also elsewhere on the board
/Connector/BREAD2_6: J2.b31; also elsewhere on the board
/Connector/BREAD2_7: J2.b32; also elsewhere on the board
/Connector/BWRITE1_0: J2.b1; also elsewhere on the board
/Connector/BWRITE1_1: J2.b2; also elsewhere on the board
/Connector/BWRITE1_2: J2.b3; also elsewhere on the board
/Connector/BWRITE1_3: J2.b4; also elsewhere on the board
/Connector/BWRITE1_4: J2.b5; also elsewhere on the board
/Connector/BWRITE1_5: J2.b6; also elsewhere on the board
/Connector/BWRITE1_6: J2.b7; also elsewhere on the board
/Connector/BWRITE1_7: J2.b8; also elsewhere on the board
/Connector/BWRITE2_0: J2.b9; also elsewhere on the board
/Connector/BWRITE2_1: J2.b10; also elsewhere on the board
/Connector/BWRITE2_2: J2.b11; also elsewhere on the board
/Connector/BWRITE2_3: J2.b12; also elsewhere on the board
/Connector/BWRITE2_4: J2.b13; also elsewhere on the board
/Connector/BWRITE2_5: J2.b14; also elsewhere on the board
/Connector/BWRITE2_6: J2.b15; also elsewhere on the board
/Connector/BWRITE2_7: J2.b16; also elsewhere on the board
/GLOBAL_CLK: J2.c18; also elsewhere on the board
/JMPSRC_CLK: J2.c20; also elsewhere on the board
/NUMBER_0: J2.c1; also elsewhere on the board
/NUMBER_1: J2.c2; also elsewhere on the board
/NUMBER_2: J2.c3; also elsewhere on the board
/NUMBER_3: J2.c4; also elsewhere on the board
/NUMBER_4: J2.c5; also elsewhere on the board
/NUMBER_5: J2.c6; also elsewhere on the board
/NUMBER_6: J2.c7; also elsewhere on the board
/NUMBER_7: J2.c8; also elsewhere on the board
/PERIPHERAL_CLK: J2.c21; also elsewhere on the board
/PROCESSOR_PAUSE: J2.a25; also elsewhere on the board
/RESET_CLK: J2.c19; also elsewhere on the board
/SPI_CS: J2.a29; also elsewhere on the board
/SPI_MISO: J2.a27; also elsewhere on the board
/SPI_MOSI: J2.a26; also elsewhere on the board
/SPI_SCLK: J2.a28; also elsewhere on the board
/SYNC_BIT: J2.c23; also elsewhere on the board
/~COUNTER_RESET: J2.c22; also elsewhere on the board
/~SELECTING_RBEXT1: J2.a30; also elsewhere on the board
/~SELECTING_RBEXT2: J2.a31; also elsewhere on the board
unnamed: D1.2 (A), R4.2
unnamed: D2.2 (A), R5.2

Notes on the sheet:
MAIN CONNECTOR
FEEDBACK

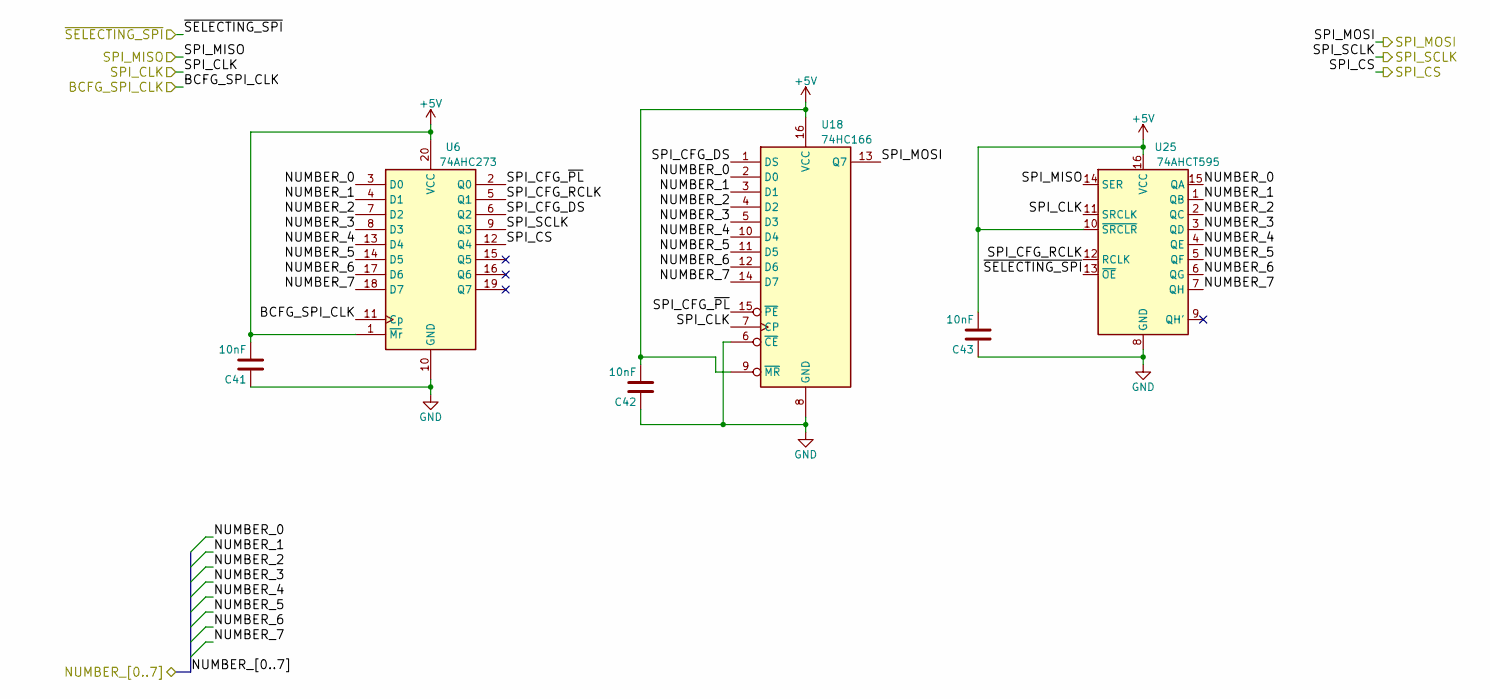
[picture p8: schematic fileSPI.kicad_sch, GP8B]

Parts:
C41, C42, C43: 10nF; C_0805_2012Metric
U6: 74AHC273; SOIC-20W_7.5x12.8mm_P1.27mm
U18: 74HC166; SOIC-16_3.9x9.9mm_P1.27mm
U25: 74AHCT595; SOIC-16_3.9x9.9mm_P1.27mm

Connections:
+5V: C41.2, C42.2, C43.2, U6.1 (~Mr), U6.20 (VCC), U18.9 (~MR), U18.16 (VCC), U25.10 (~SRCLR), U25.16 (VCC); also elsewhere on the board
/BCFG_SPI_CLK: U6.11 (Cp); also elsewhere on the board
/NUMBER_0: U6.3 (D0), U18.2 (D0), U25.15 (QA); also elsewhere on the board
/NUMBER_1: U6.4 (D1), U18.3 (D1), U25.1 (QB); also elsewhere on the board
/NUMBER_2: U6.7 (D2), U18.4 (D2), U25.2 (QC); also elsewhere on the board
/NUMBER_3: U6.8 (D3), U18.5 (D3), U25.3 (QD); also elsewhere on the board
/NUMBER_4: U6.13 (D4), U18.10 (D4), U25.4 (QE); also elsewhere on the board
/NUMBER_5: U6.14 (D5), U18.11 (D5), U25.5 (QF); also elsewhere on the board
/NUMBER_6: U6.17 (D6), U18.12 (D6), U25.6 (QG); also elsewhere on the board
/NUMBER_7: U6.18 (D7), U18.14 (D7), U25.7 (QH); also elsewhere on the board
/SPI/SPI_CFG_DS: U6.6 (Q2), U18.1 (DS)
/SPI/SPI_CFG_RCLK: U6.5 (Q1), U25.12 (RCLK)
/SPI/SPI_CFG_~PL: U6.2 (Q0), U18.15 (~PE)
/SPI_CLK: U18.7 (CP), U25.11 (SRCLK); also elsewhere on the board
/SPI_CS: U6.12 (Q4); also elsewhere on the board
/SPI_MISO: U25.14 (SER); also elsewhere on the board
/SPI_MOSI: U18.13 (Q7); also elsewhere on the board
/SPI_SCLK: U6.9 (Q3); also elsewhere on the board
/~SELECTING_SPI: U25.13 (~OE); also elsewhere on the board

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
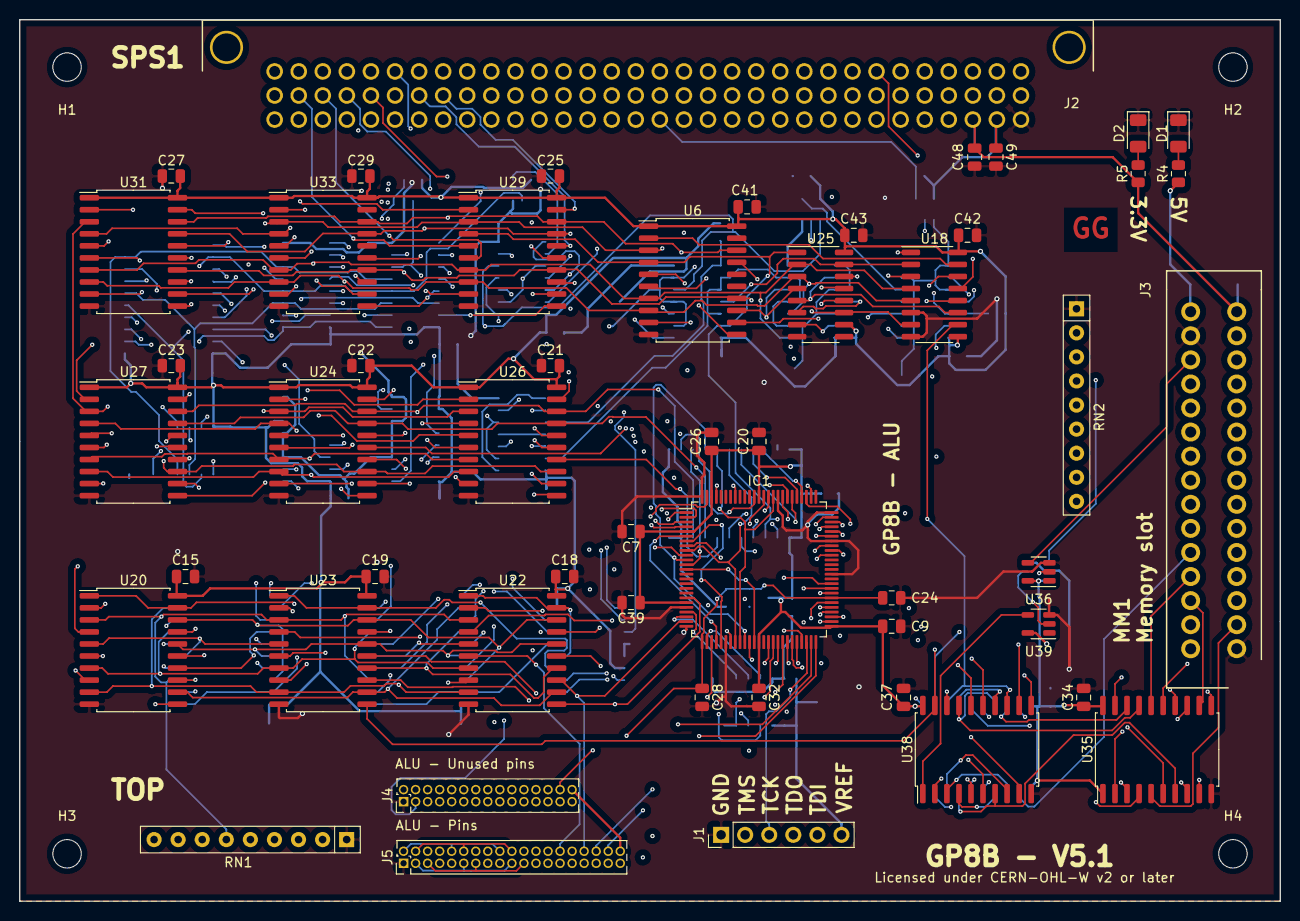
[picture p9: board Project_GP8B.kicad_pcb from above]

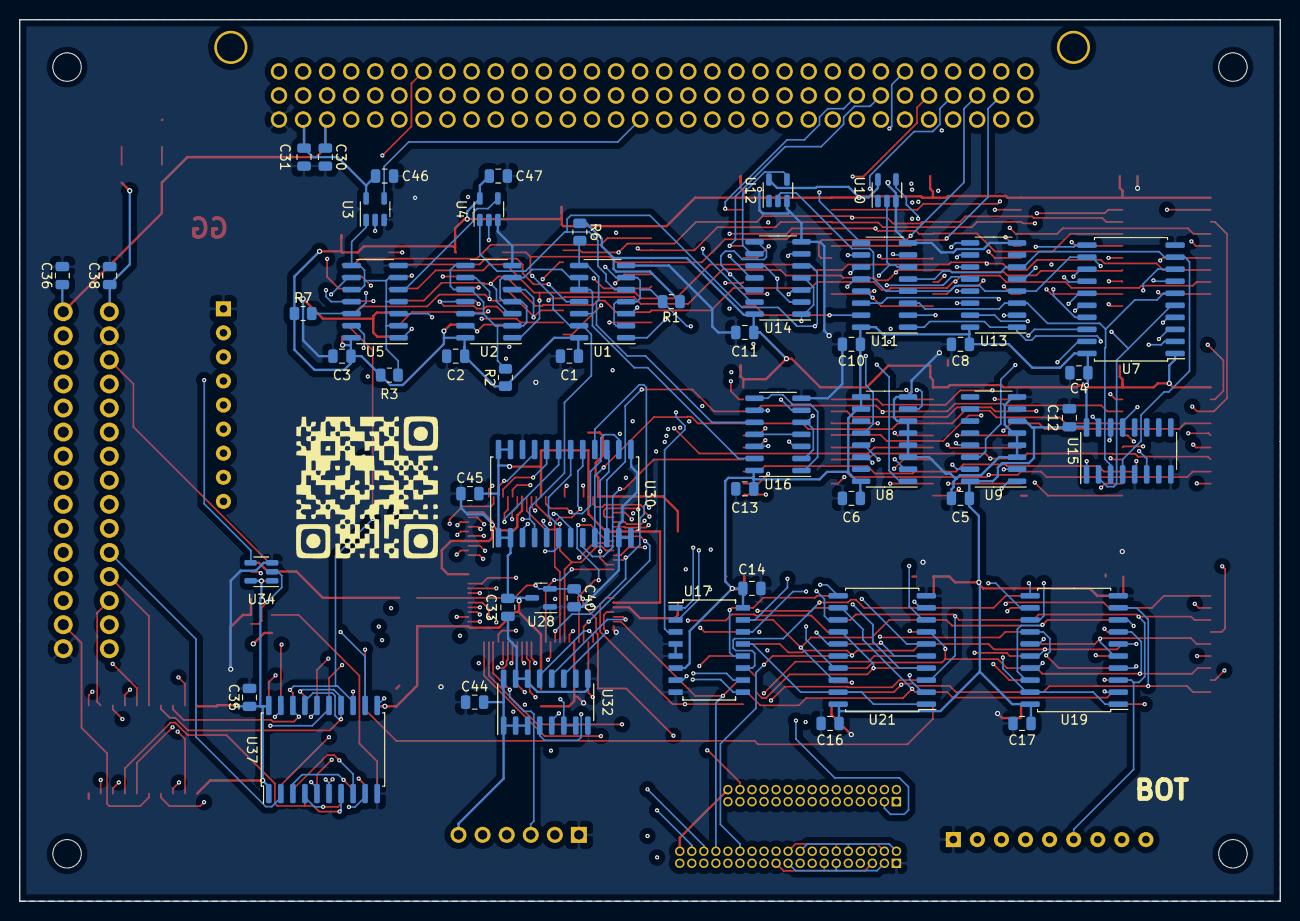
[picture p10: board Project_GP8B.kicad_pcb from below]

Board: 4 copper layers, 133.0 x 93.0 mm, 109 parts (53 on the bottom side), 229 nets.

Other parts of the board:
C46: 10nF; C_0805_2012Metric
U3: 74AHC1G02; SOT-23-5

Their connections:
+5V: C46.2, U3.5; also elsewhere on the board
/ADDSRC_CLK: U3.4; also elsewhere on the board
/GLOBAL_CLK: U3.2; also elsewhere on the board
