JonathSpirit/GP8B/(notices)

Notices in the files:
fileRAM.kicad_sch:
Copyright Guillaume Guillet 2022
Licensed under CERN-OHL-W v2 or later
